donnersm/TwinPixelAnalyzer/hardware/PCB/PCB_ASSEMBLED.png

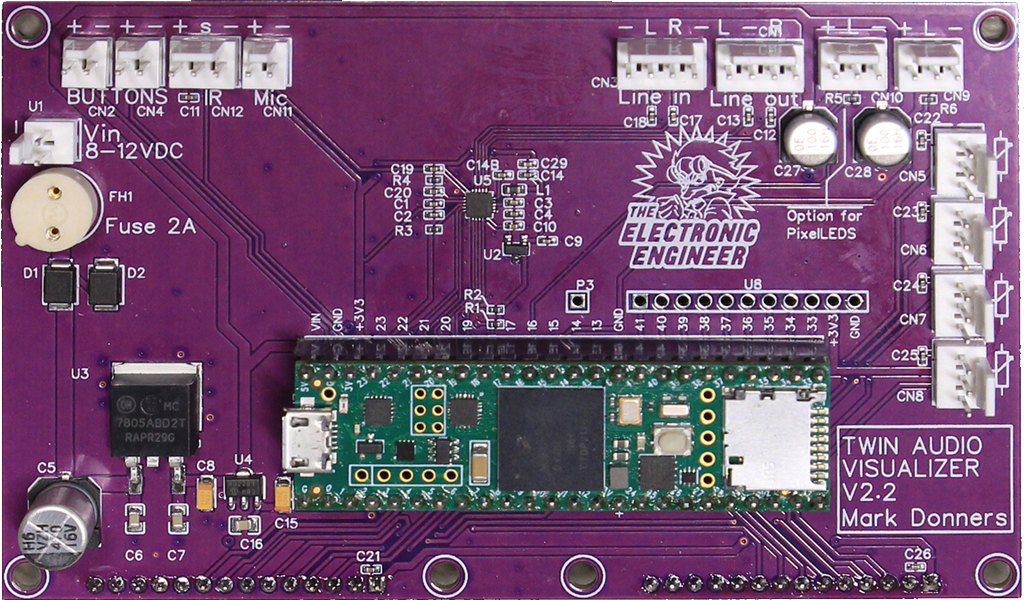
hardware/PCB/PCB_ASSEMBLED.png
