donnersm/TwinPixelAnalyzer/README.md

# TwinPixelAnalyzer
two display and one pixelled matrix - cool analyzer

This is version 2.2 of the twin analyzer
