donnersm/TwinPixelAnalyzer/hardware/PCB/Bottom_noborder.png

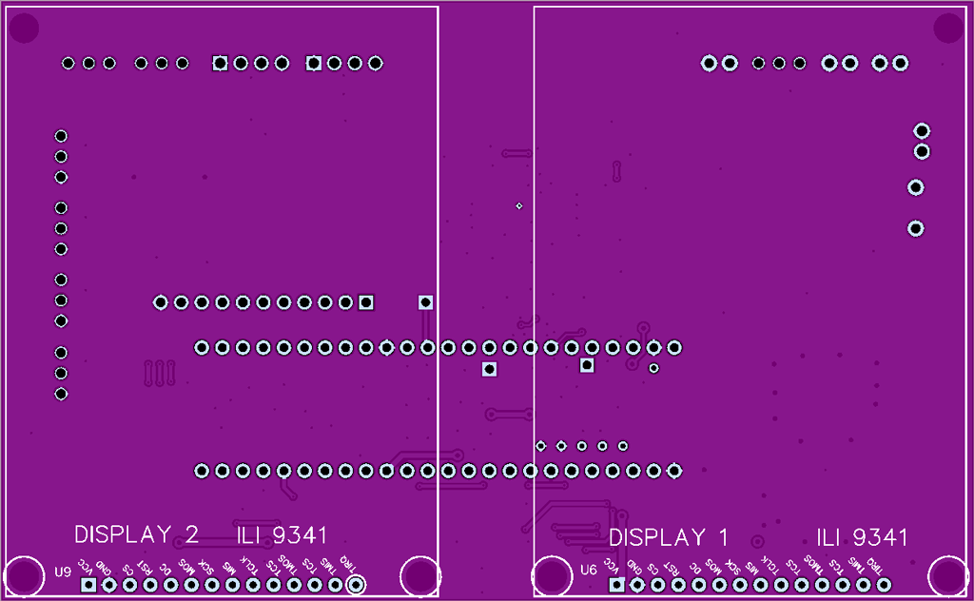
hardware/PCB/Bottom_noborder.png
