donnersm/TwinPixelAnalyzer/hardware/PCB/top_noborder.png

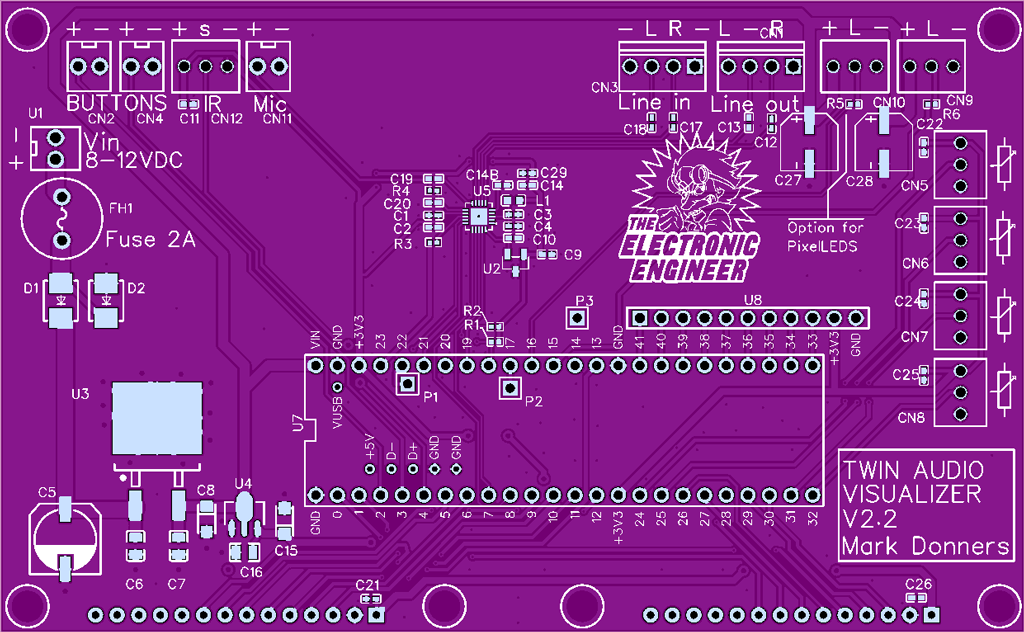
hardware/PCB/top_noborder.png
