donnersm/TwinPixelAnalyzer/hardware/Schematic_Twin-Audio-Visualizer-on-board-audio_2023-11-26.jpg

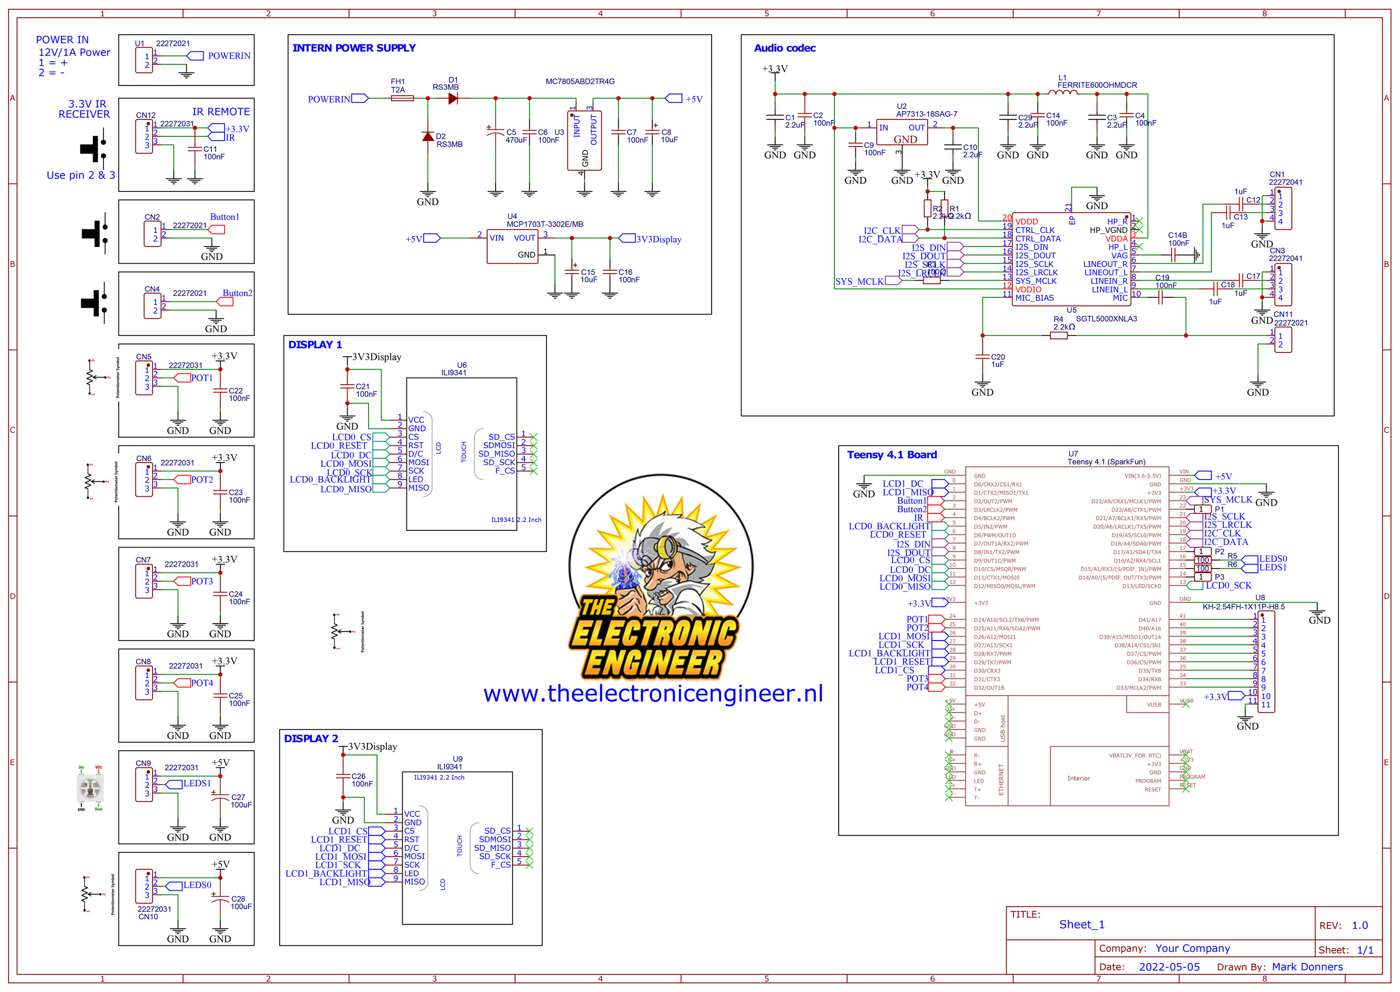
hardware/Schematic_Twin-Audio-Visualizer-on-board-audio_2023-11-26.jpg
