donnersm/TwinPixelAnalyzer/hardware/PCB/BOM_PCB_Twin Audio Visualizer_2023-10-10(2).csv

ID | Name | Designator | Footprint | Quantity | Manufacturer Part | Manufacturer | Supplier | Supplier Part | Price
1 | 2.2kΩ | R4,R1,R2 | R0402 | 3 | 0402WGF2201TCE | UNI-ROYAL(厚声) | LCSC | C25879 | 0.001
2 | 100nF | C14B,C19,C4,C9,C14 | C0402 | 5 | CL05B104KO5NNNC | SAMSUNG(三星) | LCSC | C1525 | 0.001
3 | 2.2uF | C3,C29,C1,C10 | C0402 | 4 | CL05A225MQ5NSNC | SAMSUNG(三星) | LCSC | C12530 | 0.003
4 | 100Ω | R3 | R0402 | 1 | 0402WGF1000TCE | UNI-ROYAL(厚声) | LCSC | C25076 | 0.001
5 | 1uF | C20 | C0402 | 1 | CL05A105KA5NQNC | SAMSUNG(三星) | LCSC | C52923 | 0.004
6 | 1uF | C12,C13,C17,C18 | C0402 | 4 | CL05A105KA5NQNC | SAMSUNG | LCSC | C52923 | 0.004
7 | 22272041 | CN1,CN3 | CONN-TH_22272041 | 2 | 22272041 | MOLEX | LCSC | C504991 | 0.212
8 | AP7313-18SAG-7 | U2 | SOT-23-3_L2.9-W1.3-P1.90-LS2.4-BR | 1 | AP7313-18SAG-7 | Diodes Incorporated | LCSC | C460373 | 0.084
9 | SGTL5000XNLA3 | U5 | QFN-20_L3.0-W3.0-P0.40-BL-EP1.9 | 1 | SGTL5000XNLA3 | NXP(恩智浦) | LCSC | C2802658 | 8.664
10 | 100nF | C2,C11,C21,C22,C23,C24,C25,C26 | C0402 | 8 | CL05B104KB54PNC | Samsung Electro-Mechanics | LCSC | C307331 | 0.007
11 | 22272021 | CN11,CN2,CN4,U1 | CONN-TH_22272021 | 4 | 22272021 | MOLEX | LCSC | C293316 | 0.12
12 | FERRITE600OHMDCR | L1 | L0603 | 1 | FERRITE600OHMDCR | null | LCSC | C9900000949
13 | 470uF | C5 | CAP-SMD_BD8.0-L8.3-W8.3-RD | 1 | VZH471M1CTR-0810 | LELON | LCSC | C164069 | 0.106
14 | 100nF | C6,C7,C16 | C0805 | 3 | CC0805KRX7R9BB104 | YAGEO | LCSC | C49678 | 0.004
15 | 10uF | C8,C15 | CAP-SMD_L3.2-W1.6-R-RD | 2 | TAJA106K016RNJ | AVX | LCSC | C7171 | 0.1
16 | 100uF | C27,C28 | CAP-SMD_BD6.3-L6.6-W6.6-LS7.2-R-RD | 2 | VZH101M1CTR-0606 | Lelon | LCSC | C285390 | 0.063
17 | 22272031 | CN5,CN6,CN7,CN8,CN9,CN10,CN12 | TH_3P-P2.54-V | 7 | 22272031 | MOLEX | LCSC | C471416 | 0.119
18 | 100 | R5,R6 | R0402 | 2 | 0402WGF1000TCE | UniOhm | LCSC | C25076 | 0.001
19 | MC7805ABD2TR4G | U3 | TO-263-2_L10.0-W9.1-P5.08-LS15.2-TL | 1 | MC7805ABD2TR4G | ON | LCSC | C152462 | 0.769
20 | MCP1703T-3302E/MB | U4 | SOT-89-3_L4.5-W2.5-P1.50-LS4.2-BR | 1 | MCP1703T-3302E/MB | MICROCHIP | LCSC | C27287 | 0.904
21 | Teensy 4.1 (SparkFun) | U7 | TEENSY-4.1 | 1 | DEV-16771 | SparkFun Electronics | Digi-Key | 1568-DEV-16771-ND
22 | RS3MB | D1,D2 | SMB_L4.6-W3.6-LS5.3-RD | 2 | RS3MB | Shandong Jingdao Microelectronics | LCSC | C123923 | 0.031
23 | T2A | FH1 | FUSE-TH_BD9.5-P5.08-D1.0 | 1 | 56000001009 | Littelfuse | LCSC | C142909 | 0.546
24 | ILI9341 | U6,U9 | ILI9341-2.8 | 2
