donnersm/TwinPixelAnalyzer/(list of files, cad)

Other CAD files:
hardware/housing/housingTwinPixel.dwg
