donnersm/TwinPixelAnalyzer/hardware/Schematic_Twin Audio Visualizer on board audio_2023-11-26.pdf

## HP_R

1

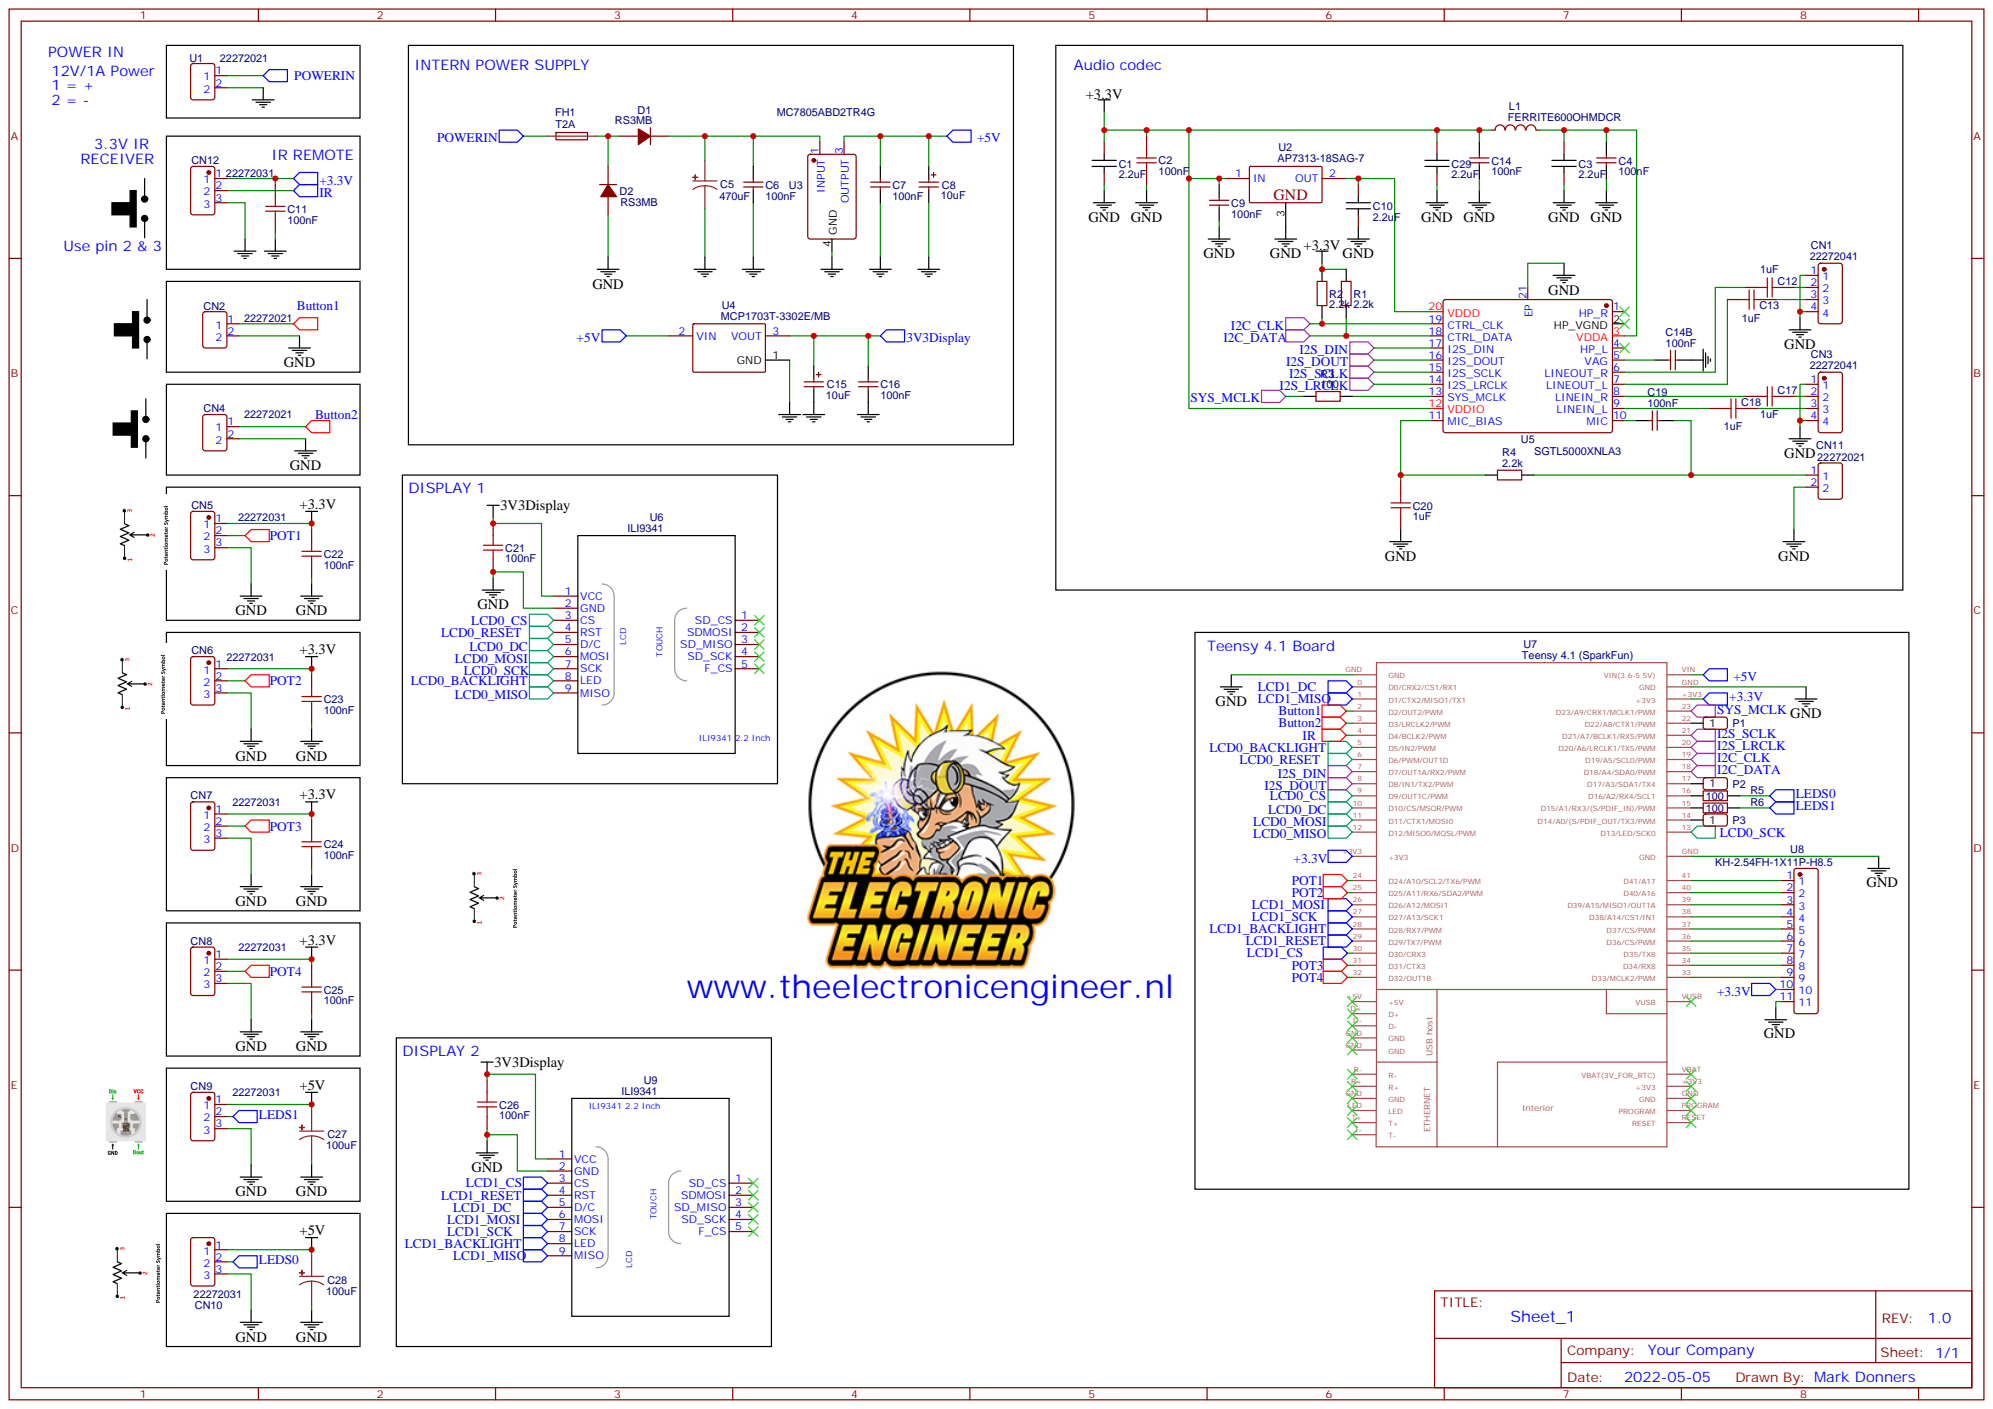
[picture p5: page 1]

Drawn By: Mark Donners
