donnersm/TwinPixelAnalyzer/Arduino Code/twin_pixel_V4.0/helpers.h

;;/// <summary>
/// get chip temp
/// </summary>
extern float tempmonGetTemp(void);

/// <summary>
/// send RMS & PPM data als one block
/// </summary>
void sendRMSPPM() {
  int dbbuf[4];
  dbbuf[0] = (int)(dBRMSL * 1000.0f); // left RMS
  dbbuf[1] = (int)(dBRMSR * 1000.0f); // right RMS
  dbbuf[2] = (int)(dBPPML * 1000.0f); // left PPM
  dbbuf[3] = (int)(dBPPMR * 1000.0f); // right PPM


}





/// <summary>
/// get Teensy infos
/// </summary>
void getControllerInfos() {
  uint8_t serial[4];
  uint8_t mac[6];
  uint8_t uid64[8];

  teensySN(serial);
  teensyMAC(mac);
  teensyUID64(uid64);

  Serial.print("{[success]Hello from the Twin Audio Visualizer with PixelLED support!}\n");
  Serial.printf("{[info][Device] Firmware: %s}\n", VERSION);
  Serial.printf("{[info][Device] Serialnumber: %s}\n", teensySN());
  Serial.printf("{[info][Device] MAC Address: %s}\n", teensyMAC());
  Serial.printf("{[info][Device] UID 64-bit: %s}\n", teensyUID64());
  Serial.printf("{[info][Device] CPU Clock Speed: %i MHz}\n", F_CPU_ACTUAL / 1000000);
  Serial.printf("{[warning][Device] CPU CoreTemp: %.1f [degrees]}\n", tempmonGetTemp());


}




/// <summary>
/// get dB gorrection data
/// </summary>
void getDBCorrectionData() {
  // dB Correction
  Serial.print("{RMSCorrectionLeft=" + String(RMSCorrectionLeft) + "}");
  Serial.print("{RMSCorrectionRight=" + String(RMSCorrectionRight) + "}");
  Serial.print("{PPMCorrectionLeft=" + String(PPMCorrectionLeft) + "}");
  Serial.print("{PPMCorrectionRight=" + String(PPMCorrectionRight) + "}");
}

/// <summary>
/// get configuration infos
/// </summary>
void getConfigurationInfos() {
  // ALL
  Serial.print("{Firmware=" + String(VERSION) + "}");
  Serial.print("{ModuleType=" + String(moduleType) + "}");
  Serial.print("{FlipScreen=" + String(flipScreen) + "}");
  Serial.print("{RemoteControlType=" + String(rcType) + "}");

  // DIGITAL
  Serial.print("{DIGITAL_ShowA700Frame=" + String(DIGITAL_ShowA700Frame) + "}");
  Serial.print("{DIGITAL_WorkMode=" + String(DIGITAL_WorkMode) + "}");
  Serial.print("{DIGITAL_ShowPeakBars=" + String(DIGITAL_ShowPeakBars) + "}");

  // ANALOG
  Serial.print("{ANALOG_ShowA700Frame=" + String(ANALOG_ShowA700Frame) + "}");
  Serial.print("{ANALOG_PeakLEDdB=" + String(ANALOG_PeakLEDdB) + "}");
  Serial.print("{ANALOG_Mode=" + String(ANALOG_Mode) + "}"); // black, white, warm

  // FFT
  Serial.print("{FFT_ShowA700Frame=" + String(FFT_ShowA700Frame) + "}");
  Serial.print("{FFT_WorkMode=" + String(FFT_WorkMode) + "}");
  Serial.print("{FFT_BarMode=" + String(FFT_BarMode) + "}");

  // GONIO
  Serial.print("{GONIO_ShowA700Frame=" + String(GONIO_ShowA700Frame) + "}");
  Serial.print("{GONIO_WorkMode=" + String(GONIO_WorkMode) + "}");
  Serial.print("{GONIO_DrawMode=" + String(GONIO_DrawMode) + "}");
}

/// <summary>
/// converts dB to RAD plus delimiter
/// </summary>
/// <param name="dB"></param>
/// <param name="dB_min"></param>
/// <param name="dB_max"></param>
/// <returns>RAD</returns>
float dBToRAD(float dB, float dB_min, float dB_max) {
  if (dB < dB_min) dB = dB_min;
  if (dB > dB_max) dB = dB_max;

  // range possible from -40dB to 7dB
  float rad = 0.00000015881455f * (dB * dB * dB * dB * dB) + 0.000014316862f * (dB * dB * dB * dB) + 0.00039325826f * (dB * dB * dB) + 0.0017871f * (dB * dB) - 0.0746641f * dB + 1.2338462f;

  if (rad < 1.0f) rad = 1.0f;
  if (rad > 2.15f) rad = 2.15f;

  return rad;
}

/// <summary>
/// converts RMS amplitude to dB plus delimiter
/// </summary>
/// <param name="amplitude"></param>
/// <param name="lr"></param>
/// <returns></returns>
float rmsAmplitudeTodB(float amplitude, int16_t lr /*0=left, 1=right*/) {
  float dB = 20.0f * log10f(amplitude * 2.0f) + 6.0f;

  if (lr == 0) {
    dB += RMSCorrectionLeft / 100.0f;  // left
    dBRMSL = dB;
  }
  if (lr == 1) {
    dB += RMSCorrectionRight / 100.0f;  // right
    dBRMSR = dB;
  }

  if (dB > dBHigh) dB = dBHigh;
  return dB;
}

/// <summary>
/// converts PEAK amplitude to dB plus delimiter, substract 'PeakAttenuation'
/// </summary>
/// <param name="amplitude"></param>
/// <param name="lr"></param>
/// <returns></returns>
float peakAmplitudeTodB(float amplitude, int16_t lr /*0=left, 1=right*/) {
  float dB = 20.0f * log10f(amplitude * 2.0f) + 3.0f;

  if (moduleType == 0) dB -= DIGITAL_PeakAttenuation;
  if (moduleType == 2) dB -= FFT_PeakAttenuation;
  if (moduleType == 3) dB -= GONIO_PeakAttenuation;

  if (lr == 0) {
    dB += PPMCorrectionLeft / 100.0f;  // left
    dBPPML = dB;
  }
  if (lr == 1) {
    dB += PPMCorrectionRight / 100.0f;  // light
    dBPPMR = dB;
  }

  if (dB > dBHigh) dB = dBHigh;
  return dB;
}

/// <summary>
/// converts FFT amplitude values to dB scale plus delimiter
/// </summary>
/// <param name="amplitude"></param>
/// <returns></returns>
float fftAmplitudeTodB(float amplitude) {
  if (amplitude < 0.01f) amplitude = 0.0f;
  float dB = 10.0f * log10f(amplitude / 0.775f);
  if (dB > dBHigh) dB = dBHigh;
  return dB;
}

/// <summary>
/// set bin ranges
/// </summary>
void setBins() {
  // frequency range for the 16 horizontal bars
  binStart16[0] = 0;  binEnd16[0] = 0;
  binStart16[1] = 1;  binEnd16[1] = 1;
  binStart16[2] = 2;  binEnd16[2] = 3;
  binStart16[3] = 4;  binEnd16[3] = 6;
  binStart16[4] = 7;  binEnd16[4] = 10;
  binStart16[5] = 11;  binEnd16[5] = 15;
  binStart16[6] = 16;  binEnd16[6] = 22;
  binStart16[7] = 23;  binEnd16[7] = 32;
  binStart16[8] = 33;  binEnd16[8] = 46;
  binStart16[9] = 47;  binEnd16[9] = 66;
  binStart16[10] = 67; binEnd16[10] = 94;
  binStart16[11] = 95; binEnd16[11] = 133;
  binStart16[12] = 134; binEnd16[12] = 187;
  binStart16[13] = 188; binEnd16[13] = 262;
  binStart16[14] = 263; binEnd16[14] = 366;
  binStart16[15] = 367; binEnd16[15] = 511;

  // frequency range for the 25 vertical bars
  binStart25[0] = 0;  binEnd25[0] = 0;
  binStart25[1] = 1;  binEnd25[1] = 1;
  binStart25[2] = 2;  binEnd25[2] = 2;
  binStart25[3] = 3;  binEnd25[3] = 4;
  binStart25[4] = 5;  binEnd25[4] = 6;
  binStart25[5] = 7;  binEnd25[5] = 9;
  binStart25[6] = 10;  binEnd25[6] = 12;
  binStart25[7] = 13;  binEnd25[7] = 16;
  binStart25[8] = 17;  binEnd25[8] = 20;
  binStart25[9] = 21;  binEnd25[9] = 25;
  binStart25[10] = 26; binEnd25[10] = 31;
  binStart25[11] = 32; binEnd25[11] = 39;
  binStart25[12] = 40; binEnd25[12] = 48;
  binStart25[13] = 49; binEnd25[13] = 59;
  binStart25[14] = 60; binEnd25[14] = 73;
  binStart25[15] = 74; binEnd25[15] = 89;
  binStart25[16] = 90; binEnd25[16] = 109;
  binStart25[17] = 110; binEnd25[17] = 133;
  binStart25[18] = 134; binEnd25[18] = 162;
  binStart25[19] = 163; binEnd25[19] = 197;
  binStart25[20] = 198; binEnd25[20] = 239;
  binStart25[21] = 240; binEnd25[21] = 289;
  binStart25[22] = 290; binEnd25[22] = 350;
  binStart25[23] = 351; binEnd25[23] = 423;
  binStart25[24] = 424; binEnd25[24] = 511;

  // frequency range for the 52 horizontal bars
  binStart52[0] = 0;    binEnd52[0] = 0;
  binStart52[1] = 1;    binEnd52[1] = 1;
  binStart52[2] = 2;    binEnd52[2] = 2;
  binStart52[3] = 3;    binEnd52[3] = 3;
  binStart52[4] = 4;    binEnd52[4] = 4;
  binStart52[5] = 5;    binEnd52[5] = 5;
  binStart52[6] = 6;    binEnd52[6] = 7;
  binStart52[7] = 8;    binEnd52[7] = 9;
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
  binStart69[53] = 232; binEnd69[53] = 243;
  binStart69[54] = 244; binEnd69[54] = 256;
  binStart69[55] = 257; binEnd69[55] = 269;
  binStart69[56] = 270; binEnd69[56] = 283;
  binStart69[57] = 284; binEnd69[57] = 298;
  binStart69[58] = 299; binEnd69[58] = 313;
  binStart69[59] = 314; binEnd69[59] = 329;
  binStart69[60] = 330; binEnd69[60] = 346;
  binStart69[61] = 347; binEnd69[61] = 364;
  binStart69[62] = 365; binEnd69[62] = 382;
  binStart69[63] = 383; binEnd69[63] = 401;
  binStart69[64] = 402; binEnd69[64] = 421;
  binStart69[65] = 422; binEnd69[65] = 442;
  binStart69[66] = 443; binEnd69[66] = 464;
  binStart69[67] = 465; binEnd69[67] = 487;
  binStart69[68] = 488; binEnd69[68] = 511;
}
