donnersm/TwinPixelAnalyzer/Arduino Code/twin_pixel_V4.0/_ili9341_t3n_font_ArialBold.h

#ifndef _ILI9341_t3n_font_ArialBold_
#define _ILI9341_t3n_font_ArialBold_

#include "ILI9341_fonts.h"

#ifdef __cplusplus
extern "C" {
#endif

extern const ILI9341_t3_font_t Arial_8_Bold;
extern const ILI9341_t3_font_t Arial_9_Bold;
extern const ILI9341_t3_font_t Arial_10_Bold;
extern const ILI9341_t3_font_t Arial_11_Bold;
extern const ILI9341_t3_font_t Arial_12_Bold;
extern const ILI9341_t3_font_t Arial_13_Bold;
extern const ILI9341_t3_font_t Arial_14_Bold;
extern const ILI9341_t3_font_t Arial_16_Bold;
extern const ILI9341_t3_font_t Arial_18_Bold;
extern const ILI9341_t3_font_t Arial_20_Bold;
extern const ILI9341_t3_font_t Arial_24_Bold;
extern const ILI9341_t3_font_t Arial_28_Bold;
extern const ILI9341_t3_font_t Arial_32_Bold;
extern const ILI9341_t3_font_t Arial_40_Bold;
extern const ILI9341_t3_font_t Arial_48_Bold;
extern const ILI9341_t3_font_t Arial_60_Bold;
extern const ILI9341_t3_font_t Arial_72_Bold;
extern const ILI9341_t3_font_t Arial_96_Bold;

#ifdef __cplusplus
} // extern "C"
#endif

#endif
